shortlab/2024-CryoHTS-Facility/figures/annotated/figure01-srim.png

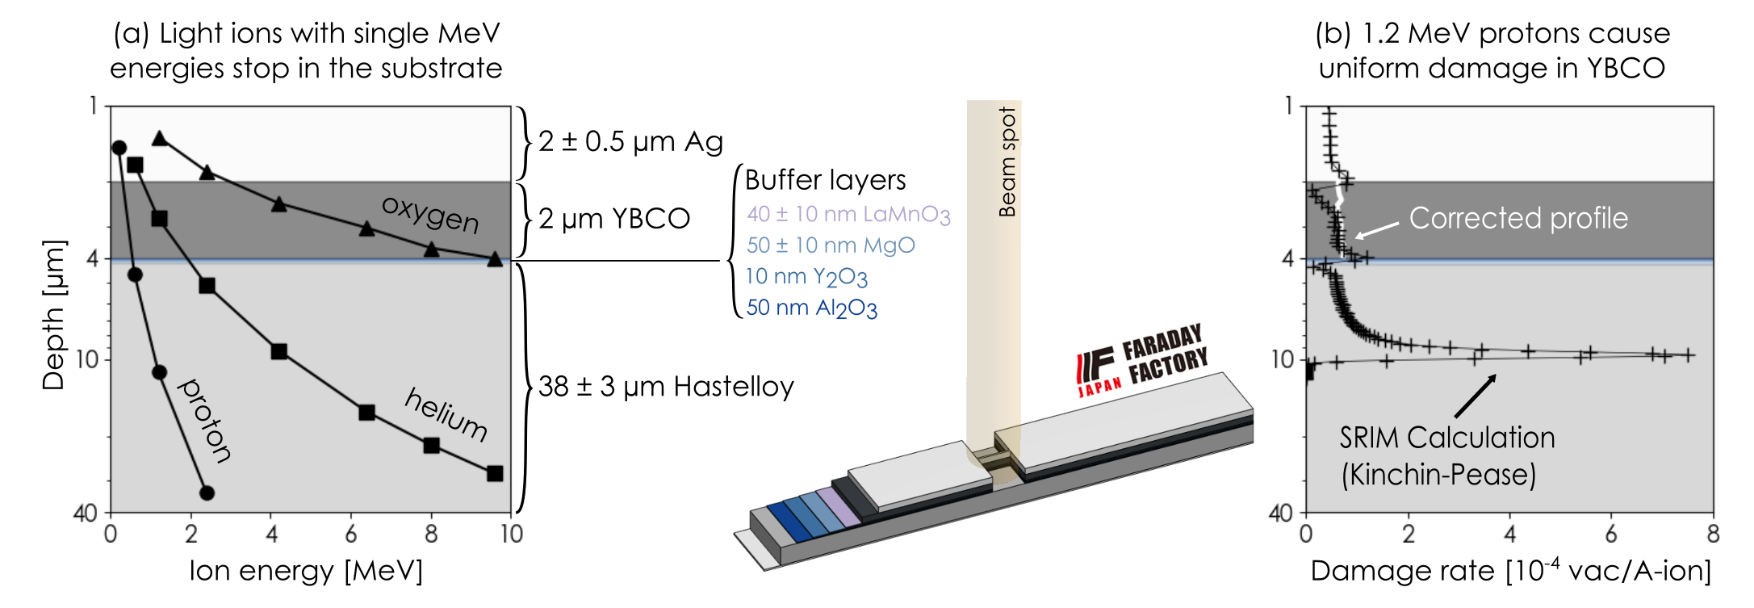
figures/annotated/figure01-srim.png
