shortlab/2024-CryoHTS-Facility/figures/annotated/figure02-beamline.png

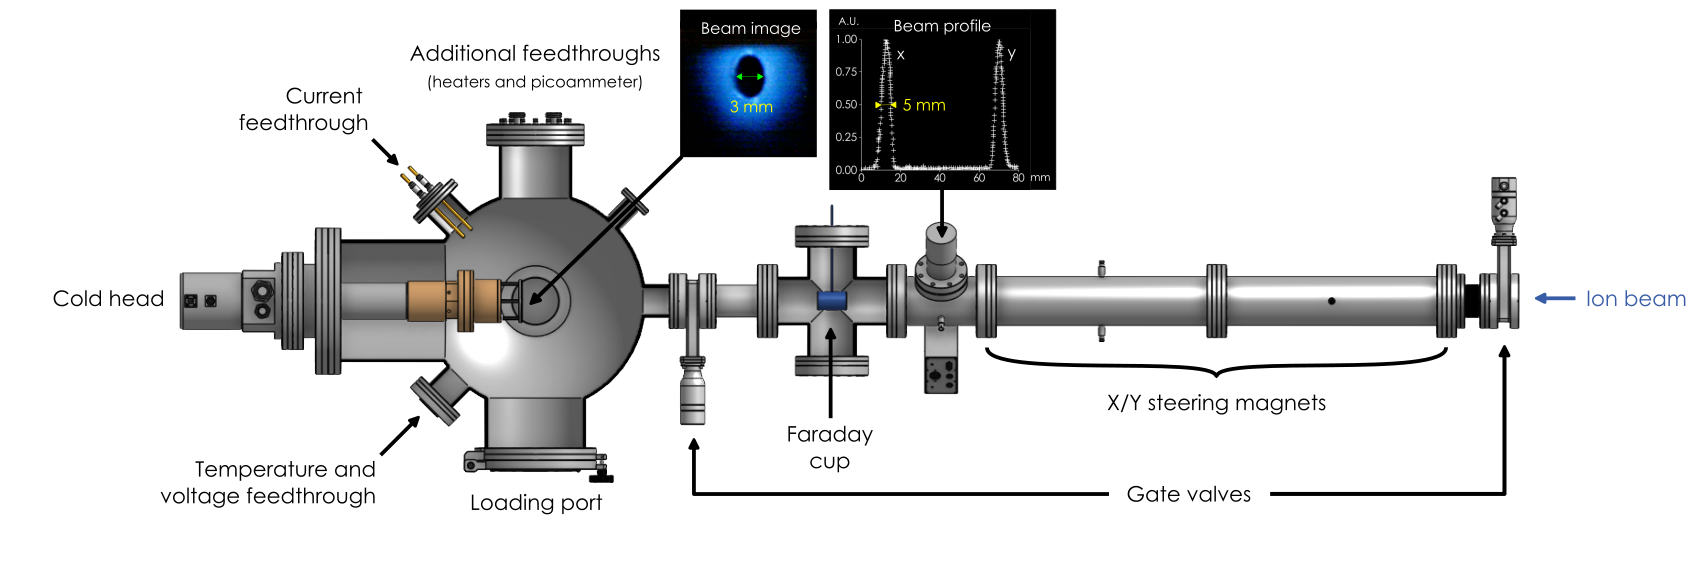
figures/annotated/figure02-beamline.png
