shortlab/2024-CryoHTS-Facility/figures/annotated/figure03-targetholder.png

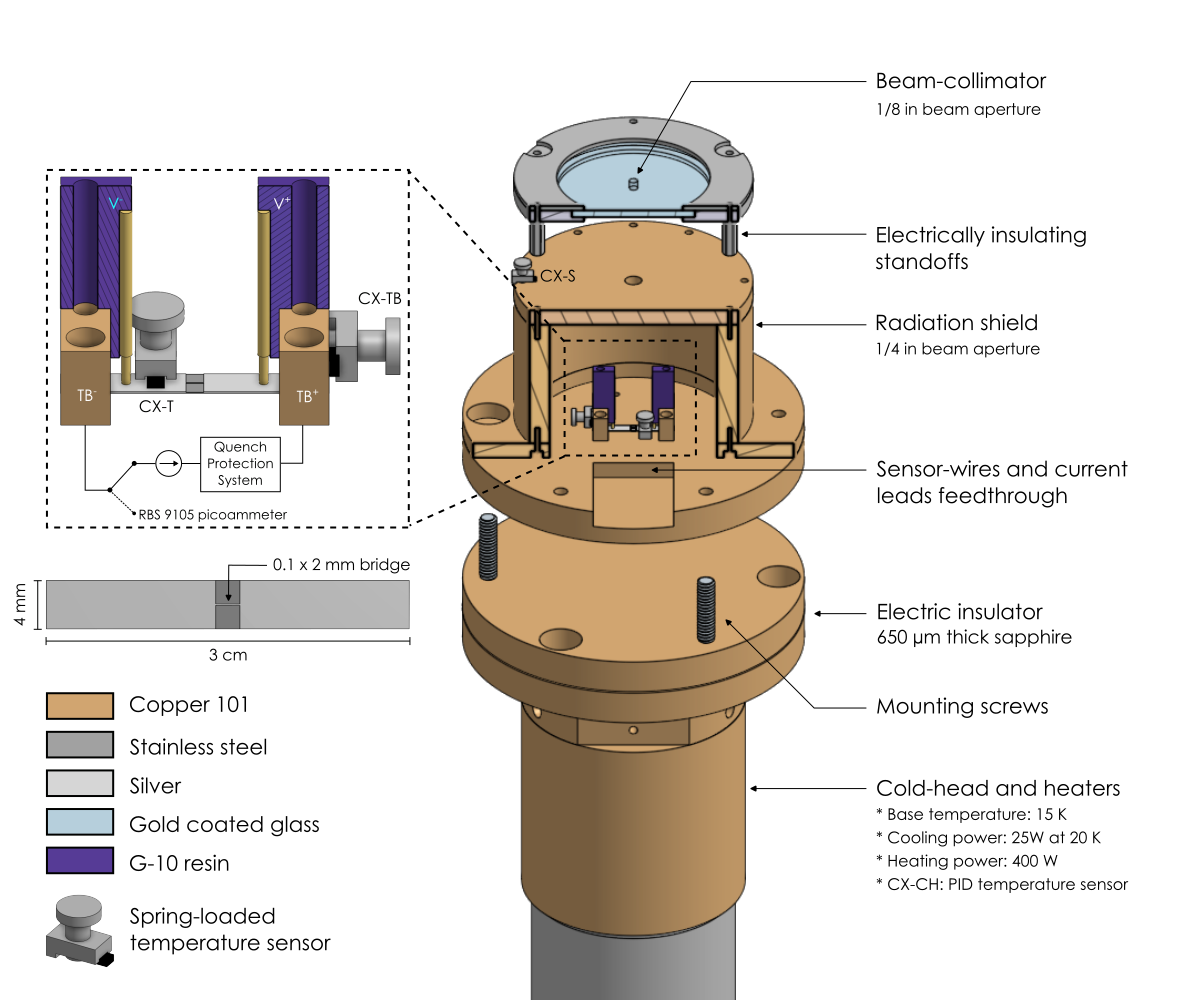
figures/annotated/figure03-targetholder.png
