shortlab/2024-CryoHTS-Facility/figures/annotated/figure04-icvt.png

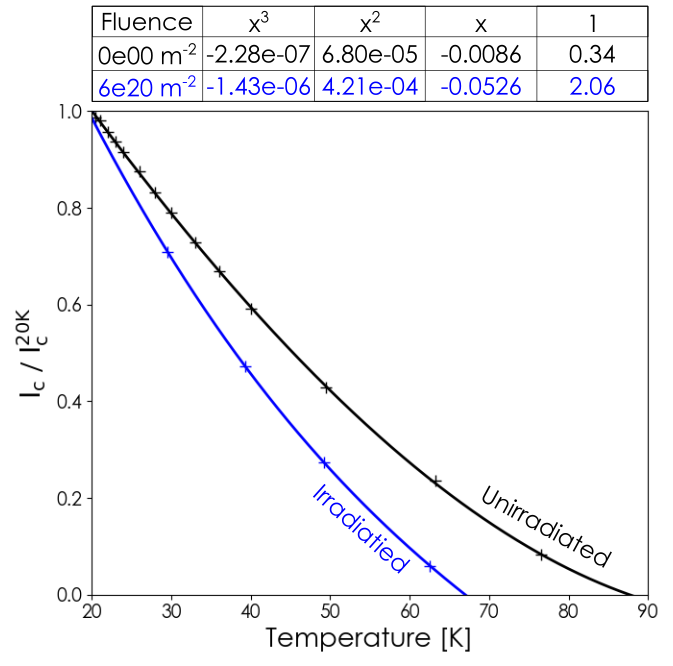
figures/annotated/figure04-icvt.png
