shortlab/2024-CryoHTS-Facility/figures/annotated/figure05-beamOnTemperature.png

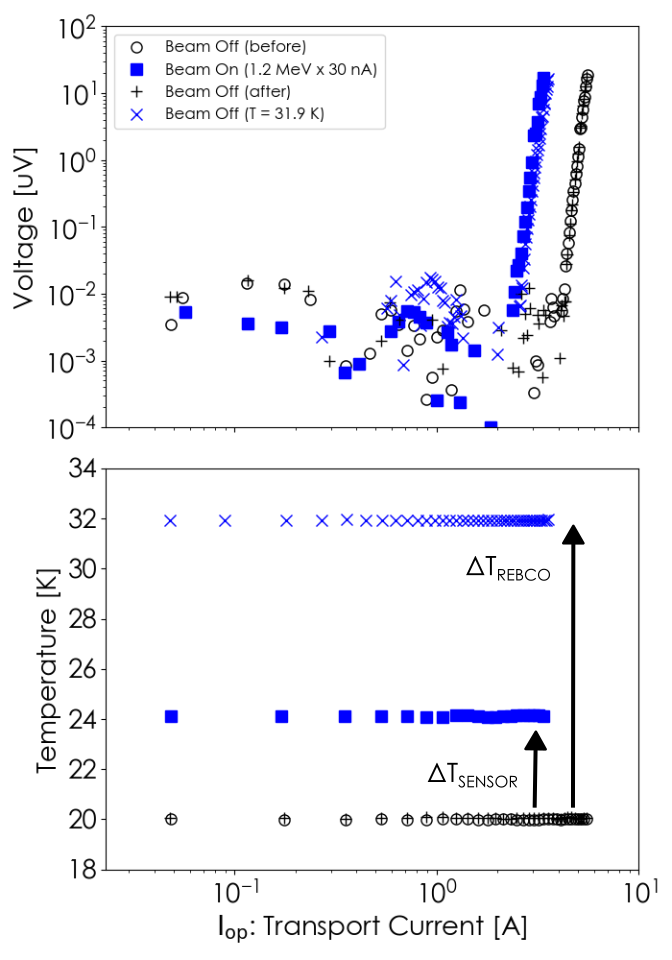
figures/annotated/figure05-beamOnTemperature.png
