shortlab/2024-CryoHTS-Facility/figures/annotated/figure06-tc.png

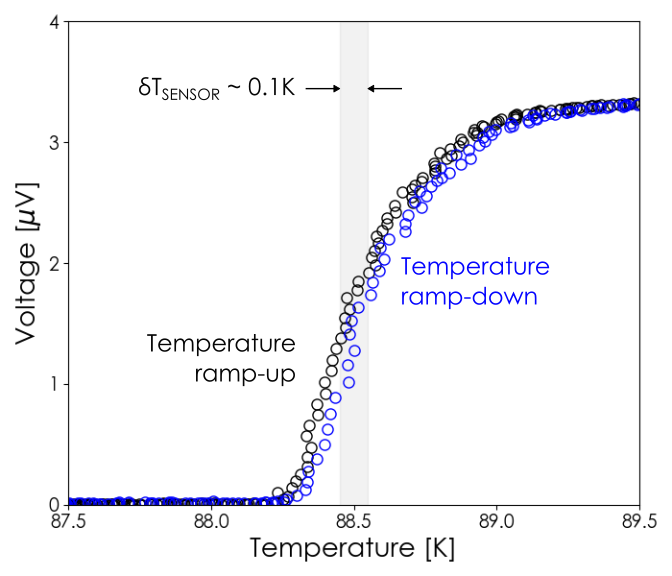
figures/annotated/figure06-tc.png
