shortlab/2024-CryoHTS-Facility/figures/annotated/figure07-qps.png

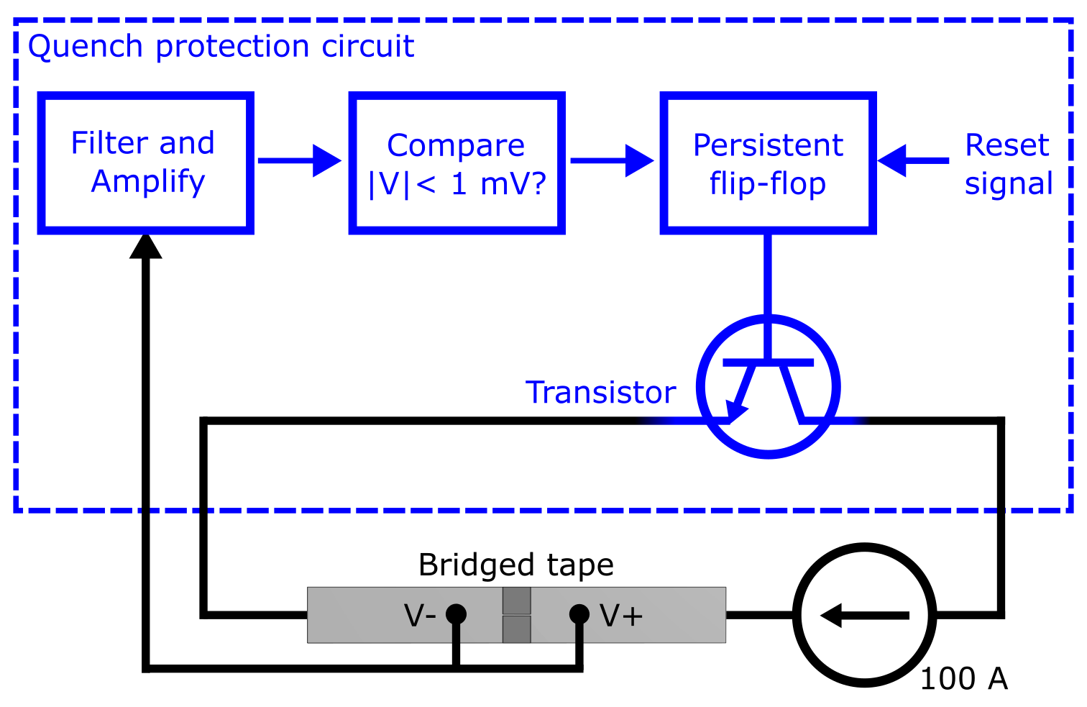
figures/annotated/figure07-qps.png
