shortlab/2024-CryoHTS-Facility/figures/annotated/figure08-fluence.png

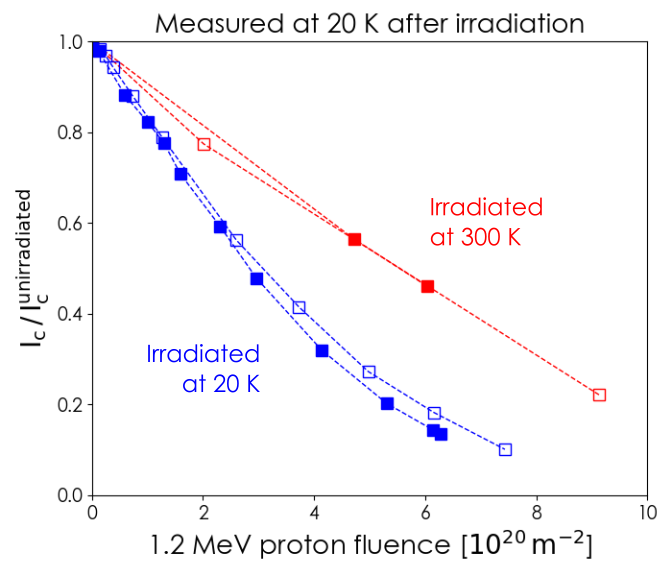
figures/annotated/figure08-fluence.png
