shortlab/2024-CryoHTS-Facility/figures/annotated/figure09-anneal.png

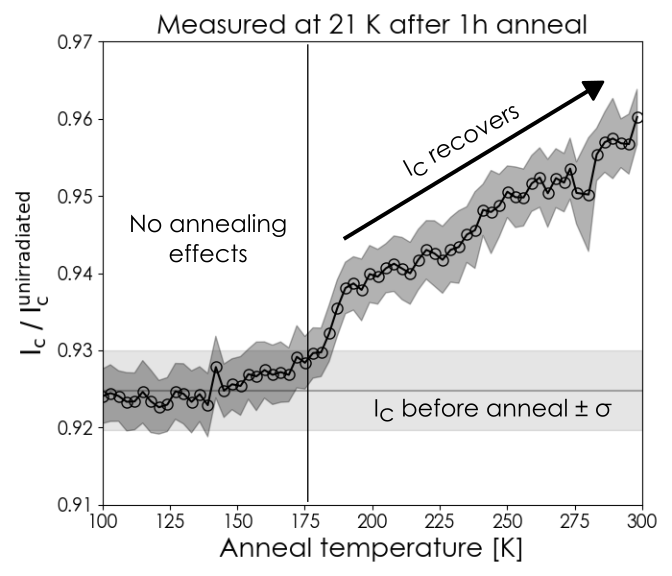
figures/annotated/figure09-anneal.png
