shortlab/2024-CryoHTS-Facility/figures/annotated/figure10-beamOnVoltage.png

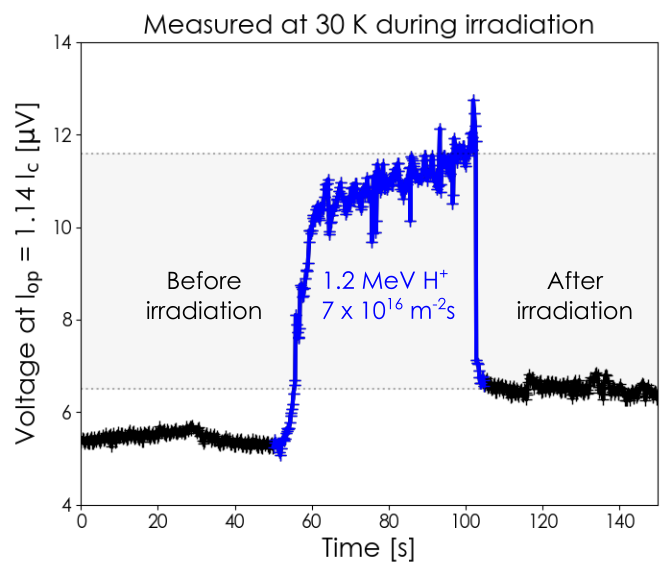
figures/annotated/figure10-beamOnVoltage.png
