shortlab/2024-CryoHTS-Facility/data/figure03/target-holder-assembly.step

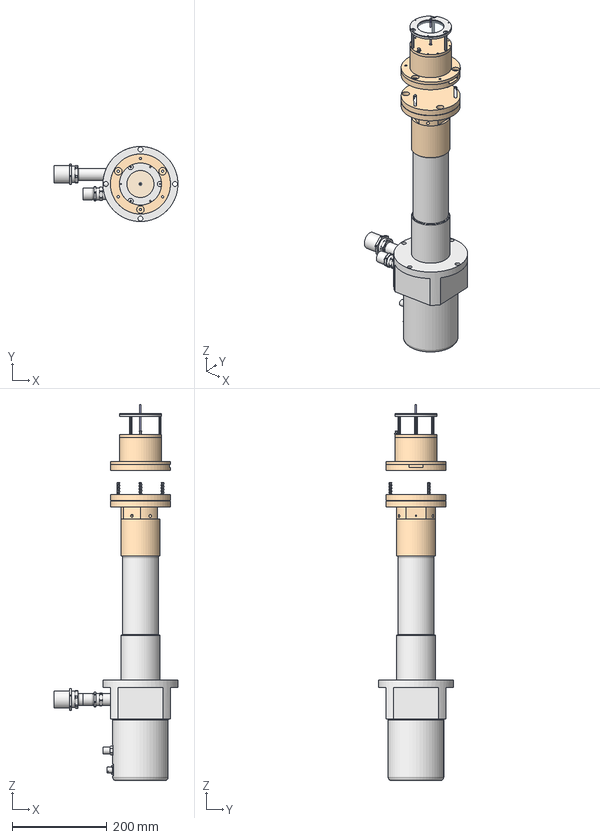
[picture p11: CAD file, 2024-04-02]
data/figure03/target-holder-assembly.step
261.9 x 158.7 x 795.1 mm
90322A645_High-Strength Steel Threaded Rod x 3
CH1A230 09MAR15 A
Beamspot
Coupler-top
adapter
Coupler
Sapphire insulator
Collimator
Collimator top
92319A884_Nylon 6-6 Plastic Hex Standoff x 3
Collimator glass
Bobbin
press x 3
CXSD x 3
Hastelloy-1
Current block 2
Pogopin x 2
Hastelloy-2
HTS
Pogocase2 x 2
Current block 1
Thermal shield - Part 1
Thermal shield - Part 3
Thermal shield - Part 2
Base
