shortlab/2024-CryoHTS-Facility/(commit log)

2024-04-02 Raw data files first lot
    Added raw data for several figures, including the temperature dependence, anneal sample, facilities 3d drawings, etc.
    [bpm-signal.csv, target-holder-assembly.step]
2024-04-02 Renamed folders to fix ordering
    [bpm-signal.csv, target-holder-assembly.step]
2024-04-02 Added temperature arrays for figure09-anneal
    The temperature arrays should be combined and referenced in the python notebook
2024-04-04 figure9 data and code
    [master.xlsx]
2024-04-04 figure 5, 8, 9, 10 and data
    [master.xlsx]
2024-04-10 all figures, and most data
    [amsc12c-300KIrradiation.xlsx, amsc12i-020KIrradiation.xlsx, f33.xlsx, ffj23-020KIrradiation.xlsx, ffj26-300KIrradiation.xlsx]
2024-04-11 more figure1 data
    [amsc12c-300KIrradiation.xlsx, amsc12i-020KIrradiation.xlsx, ffj26-020KIrradiation.xlsx, ffj33-300KIrradiation.xlsx]
2024-04-20 All flux files for figure 8
    All flux files for figure 8 are split into cumulated fluence steps and the calculation is made clear by the structure of the excel sheet.
    [ffj23-020KIrradiation.xlsx, ffj26-300KIrradiation.xlsx, ffj33-300KIrradiation.xlsx]
2024-11-16 updated beamline step file
    with exploded view of sample holder separated from permanent target assembly
2024-12-28 corrected the beamline cad
